AdrianEddy/esphome-garantia-water-level/v3/fab/jlcpcb-2026-10-17-a/BOM-garantia-knx-direct.csv

Comment | Designator | Footprint | JLCPCB Part #
4.7uF 50V | C1,C2 | Capacitor_SMD:C_1210_3225Metric | C86052
10uF 25V | C3,C19 | Capacitor_SMD:C_0805_2012Metric | C15850
47nF C0G | C4 | Capacitor_SMD:C_1206_3216Metric | C21812
220nF C0G 5% | C5 | Capacitor_SMD:C_1206_3216Metric | C464977
100nF C0G | C6 | Capacitor_SMD:C_1206_3216Metric | C170182
150uF 35V | C7 | Capacitor_SMD:CP_Elec_8x10 | C341199
100nF 50V | C8 | Capacitor_SMD:C_0603_1608Metric | C14663
22uF 10V | C9 | Capacitor_SMD:C_0805_2012Metric | C907991
100nF | C10,C11,C14,C16,C20 | Capacitor_SMD:C_0402_1005Metric | C307331
12pF | C12,C13 | Capacitor_SMD:C_0402_1005Metric | C1547
4.7uF 16V | C15 | Capacitor_SMD:C_0603_1608Metric | C19666
1nF | C17,C18 | Capacitor_SMD:C_0402_1005Metric | C1523
SS16 | D1,D4 | Diode_SMD:D_SMA | C2481
SMAJ33A | D2 | Diode_SMD:D_SMA | C113966
SMAJ40CA | D3 | Diode_SMD:D_SMA | C113970
red (prog) | D5 | LED_SMD:LED_0603_1608Metric | C2286
SMAJ15A | D6,D7 | Diode_SMD:D_SMA | C19077535
PTC 100mA 60V | F1 | Fuse:Fuse_1206_3216Metric | C883116
0R | F2 | Resistor_SMD:R_1206_3216Metric | C17888
22uH 340mA | L1 | garantia:L_APV_AHW2012FE | C6364733
220uH | L2 | Inductor_SMD:L_Sunlord_SWPA5040S | C370497
27R 1% 1W | R1 | Resistor_SMD:R_2512_6332Metric | C877905
1R | R2 | Resistor_SMD:R_0402_1005Metric | C2909329
10k | R3,R4,R5,R7,R10,R13,R15 | Resistor_SMD:R_0402_1005Metric | C25744
1k | R6 | Resistor_SMD:R_0402_1005Metric | C11702
220R 1% 1W | R8,R9 | Resistor_SMD:R_2512_6332Metric | C421609
1M | R11 | Resistor_SMD:R_0402_1005Metric | C26083
100k | R12,R16 | Resistor_SMD:R_0402_1005Metric | C25741
4.7k | R14 | Resistor_SMD:R_0402_1005Metric | C25900
33R | R17 | Resistor_SMD:R_0402_1005Metric | C25105
PROG | SW1 | Button_Switch_SMD:SW_SPST_TS-1088-xR020 | C720477
NCN5130MNTWG | U2 | knx-rgbic:onsemi_QFN-40-1EP_6x6mm_P0.5mm_EP3.2x3.2mm_ThermalVias | C513000
STM32G0B1KCU6 | U3 | Package_DFN_QFN:QFN-32-1EP_5x5mm_P0.5mm_EP3.45x3.45mm | C5270237
LTV-817S-TA1-C | U4 | Package_DIP:SMDIP-4_W9.53mm | C109227
LM2903DR2G | U5 | Package_SO:SOIC-8_3.9x4.9mm_P1.27mm | C57474
16MHz CL10pF | Y1 | Crystal:Crystal_SMD_3225-4Pin_3.2x2.5mm | C112972
