AdrianEddy/esphome-garantia-water-level/v3/hardware/kicad/garantia-knx-direct.kicad_pcb

## KiCad design v3/hardware/kicad/garantia-knx-direct.kicad_pcb (2026-11-10)

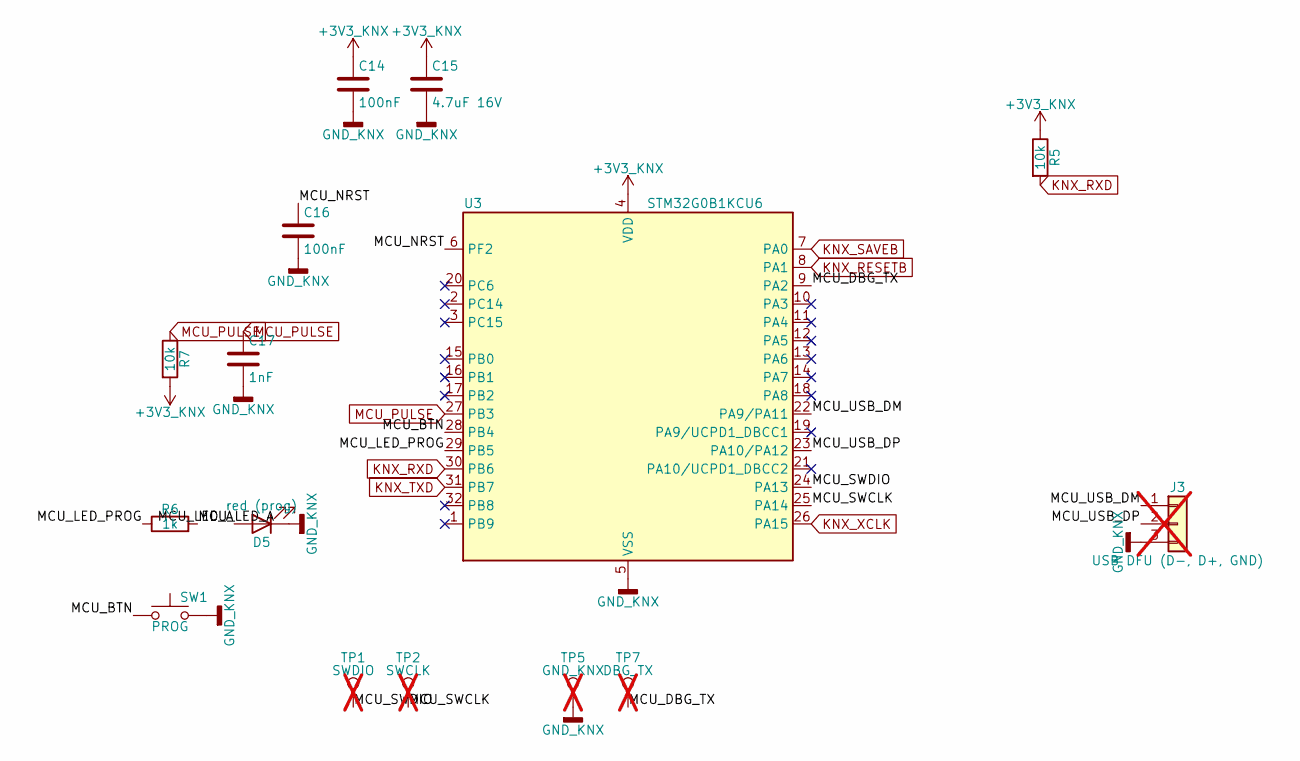
[picture p13: schematic 03_mcu.kicad_sch]

Parts:
C14, C16: 100nF; C_0402_1005Metric; MPN CL05B104KB54PNC; LCSC C307331
C15: 4.7uF 16V; C_0603_1608Metric; MPN CL10A475KO8NNNC; LCSC C19666
C17: 1nF; C_0402_1005Metric; MPN 0402B102K500NT; LCSC C1523
D5: red (prog); LED_0603_1608Metric; MPN KT-0603R; LCSC C2286
J3: USB DFU (D-, D+, GND); PinHeader_1x03_P2.54mm_Vertical; MPN 3 plated holes for a USB-C breakout (D-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; not fitted
R5, R7: 10k; R_0402_1005Metric; MPN 0402WGF1002TCE; LCSC C25744
R6: 1k; R_0402_1005Metric; MPN 0402WGF1001TCE; LCSC C11702
SW1: PROG; SW_SPST_TS-1088-xR020; MPN TS-1088-AR02016; LCSC C720477
TP1: SWDIO; TestPoint_Pad_D1.0mm; MPN test pad, not assembled; not fitted
TP2: SWCLK; TestPoint_Pad_D1.0mm; MPN test pad, not assembled; not fitted
TP5: GND_KNX; TestPoint_Pad_D1.0mm; MPN test pad, not assembled; not fitted
TP7: DBG_TX; TestPoint_Pad_D1.0mm; MPN test pad, not assembled; not fitted
U3: STM32G0B1KCU6; QFN-32-1EP_5x5mm_P0.5mm_EP3.45x3.45mm; MPN STM32G0B1KCU6; LCSC C5270237

Connections:
+3V3_KNX: C14.1, C15.1, R5.1, R7.2, U3.4 (VDD); also elsewhere on the board
/3 MCU/MCU_BTN: SW1.1, U3.28 (PB4)
/3 MCU/MCU_DBG_TX: TP7.1 (1_1), U3.9 (PA2)
/3 MCU/MCU_LED_A: D5.2 (A), R6.2
/3 MCU/MCU_LED_PROG: R6.1, U3.29 (PB5)
/3 MCU/MCU_NRST: C16.1, U3.6 (PF2)
/3 MCU/MCU_SWCLK: TP2.1 (1_1), U3.25 (PA14)
/3 MCU/MCU_SWDIO: TP1.1 (1_1), U3.24 (PA13)
/3 MCU/MCU_USB_DM: J3.1, U3.22 (PA9/PA11)
/3 MCU/MCU_USB_DP: J3.2, U3.23 (PA10/PA12)
GND_KNX: C14.2, C15.2, C16.2, C17.2, D5.1 (K), J3.3, SW1.2, TP5.1 (1_1), U3.5 (VSS), U3.33 (VSS); also elsewhere on the board
KNX_RESETB: U3.8 (PA1); also elsewhere on the board
KNX_RXD: R5.2, U3.30 (PB6); also elsewhere on the board
KNX_SAVEB: U3.7 (PA0); also elsewhere on the board
KNX_TXD: U3.31 (PB7); also elsewhere on the board
KNX_XCLK: U3.26 (PA15); also elsewhere on the board
MCU_PULSE: C17.1, R7.1, U3.27 (PB3); also elsewhere on the board

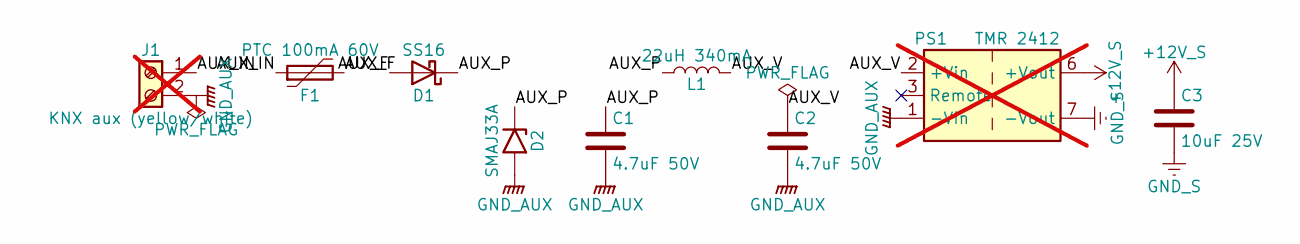
[picture p14: schematic 01_aux_power.kicad_sch]

Parts:
C1, C2: 4.7uF 50V; C_1210_3225Metric; MPN GRM32ER71H475KA88L; LCSC C86052
C3: 10uF 25V; C_0805_2012Metric; MPN CL21A106KAYNNNE; LCSC C15850
D1: SS16; D_SMA; MPN SS16; LCSC C2481
D2: SMAJ33A; D_SMA; MPN SMAJ33A; LCSC C113966
F1: PTC 100mA 60V; Fuse_1206_3216Metric; MPN BSMD1206-010-60V; LCSC C883116
J1: KNX aux (yellow/white); KNX_BusPins_2x1.0mm_P5.75mm_WAGO_243-211_Top; MPN 2x WAGO 243-131 1.0 mm solder pin (LCSC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; not fitted
L1: 22uH 340mA; L_APV_AHW2012FE; MPN AHW2012FE220KTF; LCSC C6364733
PS1: TMR 2412; Converter_DCDC_TRACO_TEC2-12xxWI_24xxWI_48xxWI_THT; MPN Traco TMR 2412 (TMR 3-2412 fits), hand-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; not fitted

Connections:
+12V_S: C3.1, PS1.6 (+Vout); also elsewhere on the board
/1 Aux power/AUX_F: D1.2 (A), F1.2
/1 Aux power/AUX_IN: F1.1, J1.1
/1 Aux power/AUX_P: C1.1, D1.1 (K), D2.1 (A1), L1.1
/1 Aux power/AUX_V: C2.1, L1.2, PS1.2 (+Vin)
GND_AUX: C1.2, C2.2, D2.2 (A2), J1.2, PS1.1 (-Vin)
GND_S: C3.2, PS1.7 (-Vout); also elsewhere on the board

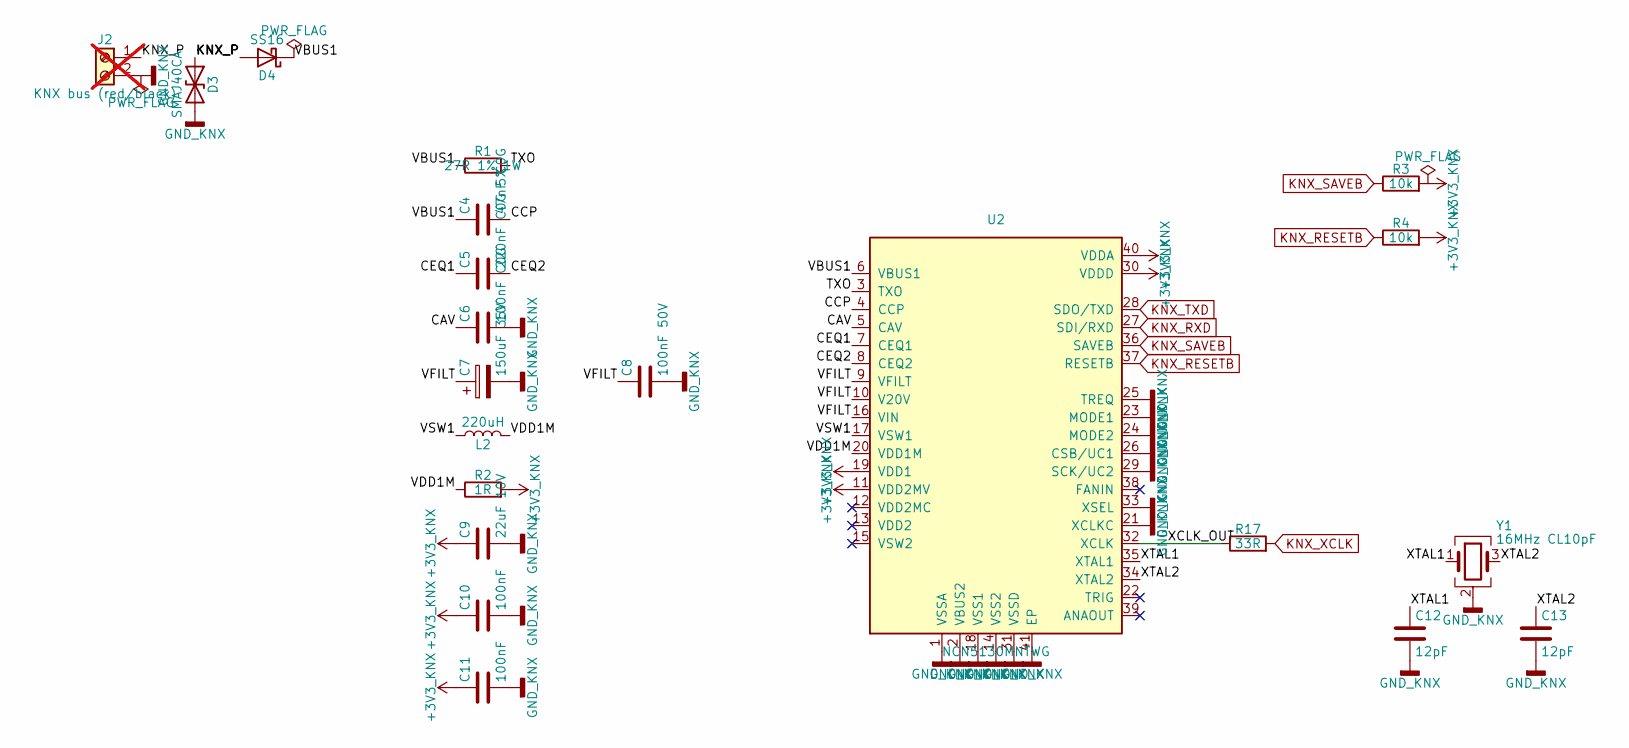
[picture p15: schematic 02_knx.kicad_sch]

Parts:
C4: 47nF C0G; C_1206_3216Metric; MPN GRM31M5C1H473JA01L; LCSC C21812
C5: 220nF C0G 5%; C_1206_3216Metric; MPN GRM31C5C1H224JE02L; LCSC C464977
C6: 100nF C0G; C_1206_3216Metric; MPN 1206N104J500CT; LCSC C170182
C7: 150uF 35V; CP_Elec_8x10; MPN EEH-ZA1V151P; LCSC C341199
C8: 100nF 50V; C_0603_1608Metric; MPN CC0603KRX7R9BB104; LCSC C14663
C9: 22uF 10V; C_0805_2012Metric; MPN GRM21BZ71A226ME15L; LCSC C907991
C10, C11: 100nF; C_0402_1005Metric; MPN CL05B104KB54PNC; LCSC C307331
C12, C13: 12pF; C_0402_1005Metric; MPN 0402CG120J500NT; LCSC C1547
D3: SMAJ40CA; D_SMA; MPN SMAJ40CA; LCSC C113970
D4: SS16; D_SMA; MPN SS16; LCSC C2481
J2: KNX bus (red/black); KNX_BusPins_2x1.0mm_P5.75mm_WAGO_243-211_Top; MPN 2x WAGO 243-131 1.0 mm solder pin (LCSC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; not fitted
L2: 220uH; L_Sunlord_SWPA5040S; MPN SWPA5040S221MT; LCSC C370497
R1: 27R 1% 1W; R_2512_6332Metric; MPN RC2512FK-0727RL; LCSC C877905
R2: 1R; R_0402_1005Metric; MPN FRC0402F1R00TS; LCSC C2909329
R3, R4: 10k; R_0402_1005Metric; MPN 0402WGF1002TCE; LCSC C25744
R17: 33R; R_0402_1005Metric; MPN 0402WGF330JTCE; LCSC C25105
U2: NCN5130MNTWG; onsemi_QFN-40-1EP_6x6mm_P0.5mm_EP3.2x3.2mm_ThermalVias; MPN NCN5130MNTWG; LCSC C513000
Y1: 16MHz CL10pF; Crystal_SMD_3225-4Pin_3.2x2.5mm; MPN X322516MMB4SI; LCSC C112972

Connections:
+3V3_KNX: C9.1, C10.1, C11.1, R2.2, R3.2, R4.2, U2.11 (VDD2MV), U2.19 (VDD1), U2.30 (VDDD), U2.40 (VDDA); also elsewhere on the board
/2 KNX bus interface/CAV: C6.1, U2.5 (CAV)
/2 KNX bus interface/CCP: C4.2, U2.4 (CCP)
/2 KNX bus interface/CEQ1: C5.1, U2.7 (CEQ1)
/2 KNX bus interface/CEQ2: C5.2, U2.8 (CEQ2)
/2 KNX bus interface/KNX_P: D3.1 (A1), D4.2 (A), J2.1
/2 KNX bus interface/TXO: R1.2, U2.3 (TXO)
/2 KNX bus interface/VBUS1: C4.1, D4.1 (K), R1.1, U2.6 (VBUS1)
/2 KNX bus interface/VDD1M: L2.2, R2.1, U2.20 (VDD1M)
/2 KNX bus interface/VFILT: C7.1, C8.1, U2.9 (VFILT), U2.10 (V20V), U2.16 (VIN)
/2 KNX bus interface/VSW1: L2.1, U2.17 (VSW1)
/2 KNX bus interface/XCLK_OUT: R17.1, U2.32 (XCLK)
/2 KNX bus interface/XTAL1: C12.1, U2.35 (XTAL1), Y1.1
/2 KNX bus interface/XTAL2: C13.1, U2.34 (XTAL2), Y1.3
GND_KNX: C6.2, C7.2, C8.2, C9.2, C10.2, C11.2, C12.2, C13.2, D3.2 (A2), J2.2, U2.1 (VSSA), U2.2 (VBUS2), U2.14 (VSS2), U2.18 (VSS1), U2.21 (XCLKC), U2.23 (MODE1), U2.24 (MODE2), U2.25 (TREQ), U2.26 (CSB/UC1), U2.29 (SCK/UC2), U2.31 (VSSD), U2.33 (XSEL), U2.41 (EP), Y1.2 (G), Y1.4 (G); also elsewhere on the board
KNX_RESETB: R4.1, U2.37 (RESETB); also elsewhere on the board
KNX_RXD: U2.27 (SDI/RXD); also elsewhere on the board
KNX_SAVEB: R3.1, U2.36 (SAVEB); also elsewhere on the board
KNX_TXD: U2.28 (SDO/TXD); also elsewhere on the board
KNX_XCLK: R17.2; also elsewhere on the board

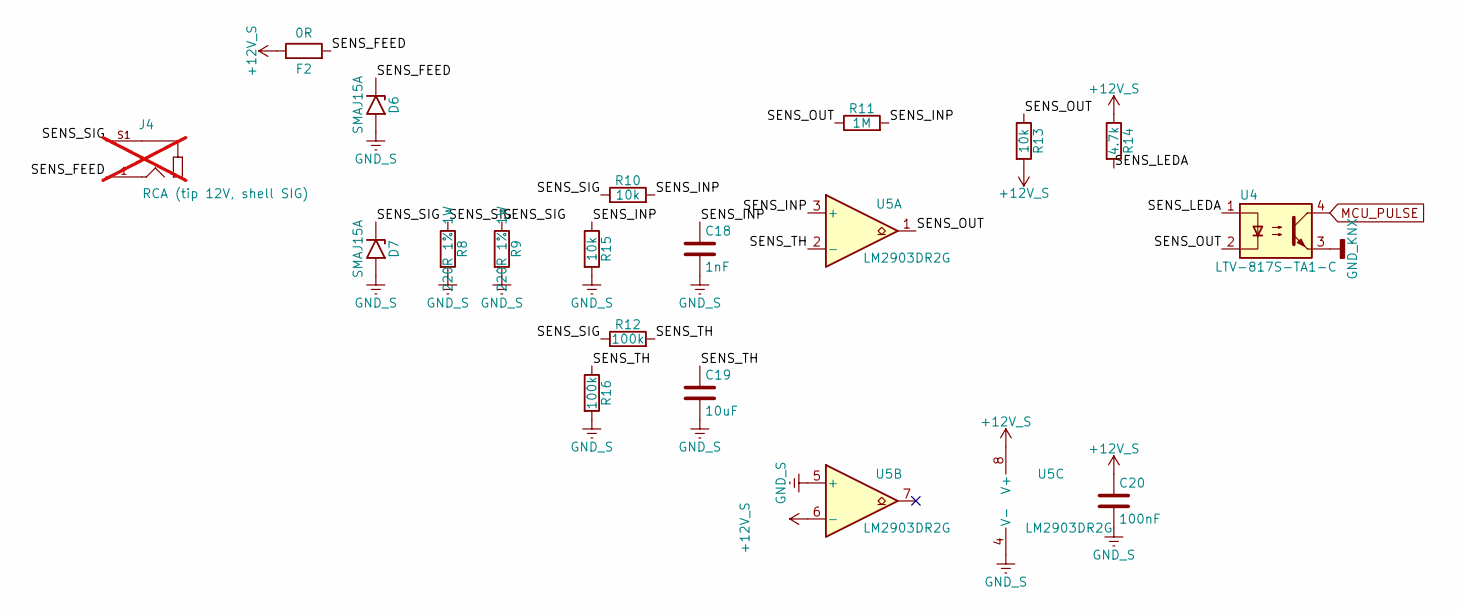
[picture p16: schematic 04_sensor.kicad_sch]

Parts:
C18: 1nF; C_0402_1005Metric; MPN 0402B102K500NT; LCSC C1523
C19: 10uF; C_0805_2012Metric; MPN CL21A106KAYNNNE; LCSC C15850
C20: 100nF; C_0402_1005Metric; MPN CL05B104KB54PNC; LCSC C307331
D6, D7: SMAJ15A; D_SMA; MPN SMAJ15A; LCSC C19077535
F2: 0R; R_1206_3216Metric; MPN 1206W4F0000T5E; LCSC C17888
J4: RCA (tip 12V, shell SIG); KEYSTONE_900; MPN Keystone 900 (owner's stock), hand-fitt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; not fitted
R8, R9: 220R 1% 1W; R_2512_6332Metric; MPN 25121WF2200T4E; LCSC C421609
R10, R13, R15: 10k; R_0402_1005Metric; MPN 0402WGF1002TCE; LCSC C25744
R11: 1M; R_0402_1005Metric; MPN 0402WGF1004TCE; LCSC C26083
R12, R16: 100k; R_0402_1005Metric; MPN 0402WGF1003TCE; LCSC C25741
R14: 4.7k; R_0402_1005Metric; MPN 0402WGF4701TCE; LCSC C25900
U4: LTV-817S-TA1-C; SMDIP-4_W9.53mm; MPN LTV-817S-TA1-C; LCSC C109227
U5: LM2903DR2G; SOIC-8_3.9x4.9mm_P1.27mm; MPN LM2903DR2G; LCSC C57474

Connections:
+12V_S: C20.1, F2.1, R13.2, R14.1, U5.6 (-), U5.8 (V+); also elsewhere on the board
/4 Sensor/SENS_FEED: D6.1 (A1), F2.2, J4.1
/4 Sensor/SENS_INP: C18.1, R10.2, R11.2, R15.1, U5.3 (+)
/4 Sensor/SENS_LEDA: R14.2, U4.1
/4 Sensor/SENS_OUT: R11.1, R13.1, U4.2, U5.1
/4 Sensor/SENS_SIG: D7.1 (A1), J4.S1, J4.S2, J4.S3, R8.1, R9.1, R10.1, R12.1
/4 Sensor/SENS_TH: C19.1, R12.2, R16.1, U5.2 (-)
GND_KNX: U4.3; also elsewhere on the board
GND_S: C18.2, C19.2, C20.2, D6.2 (A2), D7.2 (A2), R8.2, R9.2, R15.2, R16.2, U5.4 (V-), U5.5 (+); also elsewhere on the board
MCU_PULSE: U4.4; also elsewhere on the board

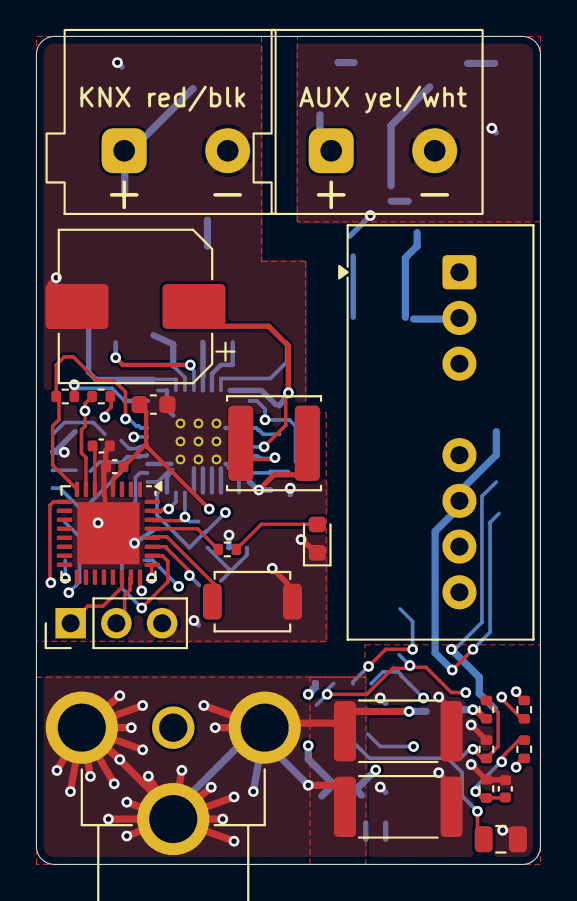
[picture p17: board garantia-knx-direct.kicad_pcb from above]

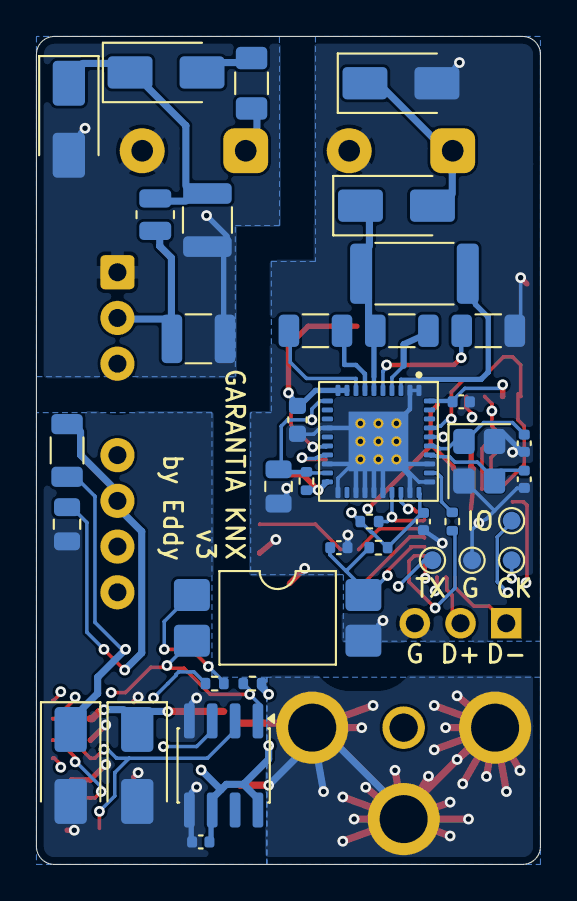
[picture p18: board garantia-knx-direct.kicad_pcb from below]

Board: 4 copper layers, 28.0 x 46.0 mm, 63 parts (38 on the bottom side), 43 nets.
