AdrianEddy/esphome-garantia-water-level/v3/firmware/u3/src/app/version.h

/* version.h: U3 application version (0xMMmm), in the image descriptor and the log. Bump on every release;
 * the .knxprod's application version (knxprod/spec.py APP_VERSION) is a separate number. */
#pragma once

#define U3_FW_VERSION 0x0102u   /* 1.2 */
